NIKUNJMAHAJAN/Self-Balancing-Robot/PHOTO-2025-05-15-12-05-04.jpg

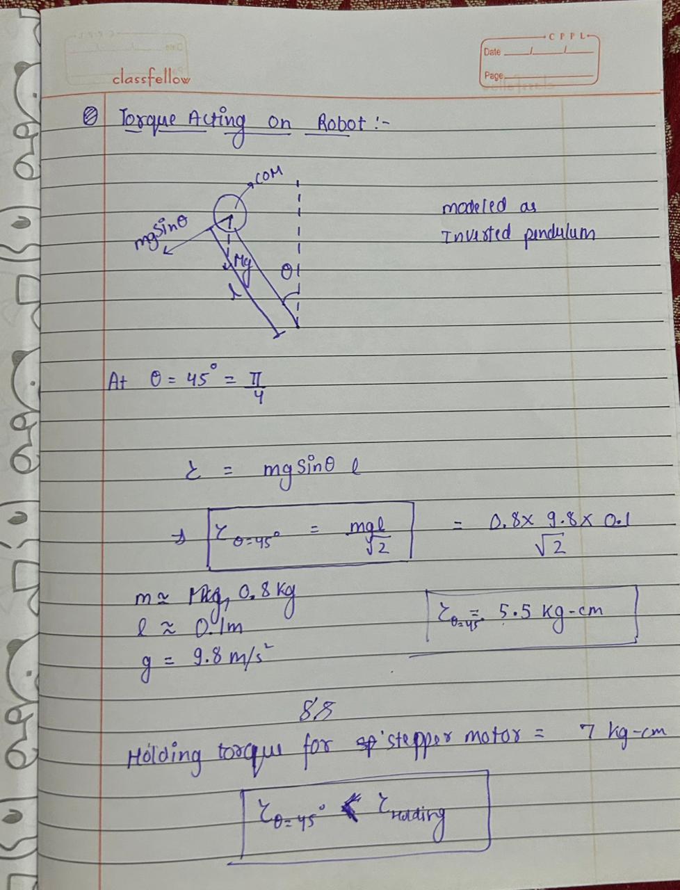
PHOTO-2025-05-15-12-05-04.jpg
